JungMatthieu/UWOS/README.md

# UWOS
UWOS (UnderWater Optical Sensor), is an open source, low-cost, low power optical senso that can be synchronized with the Qualilife HighBlue (QHB, developed by the SMIoT laboratory at theUniversity of Toulon) passive acoustic recorder.
