JungMatthieu/UWOS/DOCS/STAGE___CNRS_DYNI___Cahier_des_Charges-2.pdf

# Cahier des Charges : Implémentation d’un capteur optique en « HighBlue »

### Stage de fin d’étude Mars 2025 à Août 2025

### Matthieu JUNG

Julie Patris, Hervé Glotin, Valentin Gies, Iván Hinojosa, Franck Malige,

### Lyudmyla Yushchenko

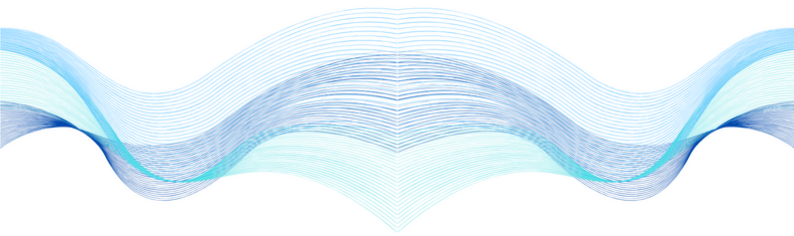
[picture p100: figure]

### Table des matières

Historique des Versions | 2
1 Object | 3
2 Cahier des charges fonctionnel (CdcF) | 5
3 Analyse Fonctionnelle Technique (AFT) | 9
4 Mode de défaillance | 21
5 Planning et suivi de projet | 22
Références | 23
Table des Figures et Tableaux | 23

1

### Historique des Versions

Version | Date | Auteur(s) | Modifications
1.0 | 10.03.2025 | M. JUNG | Cahier des charges fonctionnel
2.0 | 19.03.2025 | M. JUNG | Analyse fonctionnelle Technique
3.0 | 19.03.2025 | M. JUNG | Versión en español
4.0 | 17.03.2025 | | Finale Version

2

INTRODUCTION

### 1 Object

### 1.1 Objectif du document

Ce projet vise à compléter les enregistrements hydrophones de notre outil d’enregistrement sous-marin "Qualilife HighBlue" ancré et utilisé pour effectuer des relevés bioacoustique. Due a une convergence évolutive, certaines espèces, comme des dauphins et des marsouins émettent des clicks NBHF dans le même spectre de fréquence, il est difficile de les distinguer uniquement par l’audio comme évoquer dans (Patris 2023, [1] et Reyes Reyes 2018, [2]). L’écosystème marin du Chili est considéré comme l’un des plus riche, dans le cadre de l’étude des espèces endémique s’y trouvant, l’ajout d’un capteur optique sous-marin permettra d’améliorer l’identification des espèces grâce à une analyse visuelle, soit manuellement, soit via IA, et donc par conséquent de relier l’audio a des individus et des comportements.

### 1.2 Conventions et définitions

Ce document suit les conventions suivantes :
— Les termes techniques et acronymes spécifiques au projet sont définis dans le glossaire cidessous.
— Les références aux sources bibliographiques sont indiquées sous la forme (Auteur, année) et détaillées dans la section des références.

Définitions
— NBHF (Narrow-Band High-Frequency clicks) : Clicks de haute fréquence émis par certains cétacés comme les marsouins et certains dauphins.
— Qualilife HighBlue (QHB) : Carte électronique d’enregistrement audio
— Caméra 360° sous-marine : Système optique capable de capturer des images et vidéos panoramiques sous l’eau à différentes profondeurs.
— DC : Courant continu
— AC : Courant alternatif
— Lowpower : Conçu pour avoir une faible consommation énergétique — UWOS : UnderWater optic sensor

### 1.3 Analyse de l’existant

Aujourd’hui sur la bouée d’enregistrement, aucun capteur optique n’est présent. On note cependant la présence de deux hydrophones.

### 1.4 Public cible et lecture recommandée

Ce document est destiné à plusieurs catégories de lecteurs :
— Équipe d’ingénierie : Concepteurs, développeurs et intégrateurs du système caméra.
— Biologistes : Utilisateurs finaux exploitant les données pour l’analyse bioacoustique et comportementale.
— Spécialistes en intelligence artificielle : Développeurs d’algorithmes de reconnaissance d’espèces via l’analyse d’images et d’audio.
— Partenaires techniques et industriels : Fabricants et fournisseurs impliqués dans le développement matériel et logiciel du système.
SeaTech - SYSMER 3A | 3 | CNRS - LIS DYNI

INTRODUCTION

### 1.5 Portée du projet

Ce projet vise à concevoir et développer un système de module de capture optique adaptatif, modulable sous-marin lowpower, capable de fonctionner en milieu subaquatique pendant de longues périodes en autonomie et donc aussi dans différentes configurations.
Principaux objectifs :

— Acquisition optique complémentaire aux enregistrements acoustiques.
— Conception robuste et étanche : Résistance aux conditions extrêmes (pression, salinité, température, courant).

— Optimisation énergétique : Système lowpower permettant une autonomie prolongée.
— Stockage : Enregistrement local des vidéos.
— Traitement avancé des données : Compatibilité avec un post-processing.

Exclusions du projet :
Le projet ne comprend pas la mise en place d’un réseau de transmission temps réel longue portée, Ni le développement d’un algorithme IA complet pour l’identification des espèces est hors du périmètre initial (mais le système doit être compatible avec une future intégration).
SeaTech - SYSMER 3A | 4 | CNRS - LIS DYNI

CAHIER DES CHARGES FONCTIONNEL

### 2 Cahier des charges fonctionnel (CdcF)

### 2.1 Analyse du cycle de vie

Le cycle de vie d’un module UWOS sous-marine low-power suit plusieurs étapes, depuis sa conception jusqu’à son recyclage en fin de vie.

— Phase de conception et développement
— Phase de fabrication
— Phase de transport
— Phase d’exploitation et d’utilisation
— Fin de vie et recyclage

Dans notre cas il est possible qu’au vu de la temporalité (moins de 3 mois de R&D) de ce projet les phases de conception, fabrication et d’exploitation soit un peu confondu. En effet il est probable que la solution reste à l’état de prototype durant ce projet.

### 2.2 Éléments du milieu extérieur (EME)

L’environnement sous-marin impose des contraintes physiques et chimiques qui influencent la conception. (Pression, corrosion, salinité, visibilité...)
Les éléments du milieu extérieur sont les éléments constitutif de l’environnement de notre système optique, qui sont en interaction avec celui-ci. On retiendra les EME suivantes :

— Système d’enregistrement existant
— Utilisateur
— Réglementation et norme
— Environnement sous-marin (cf ci-dessus)

Dans les diagrammes dans la partie suivante, l’EME Système existant sera divisé en plusieurs sous-partie pour une meilleure visibilité.

SeaTech - SYSMER 3A | 5 | CNRS - LIS DYNI

CAHIER DES CHARGES FONCTIONNEL

### 2.3 Situation de vie, utilisation

### 2.3.1 Diagramme APTE

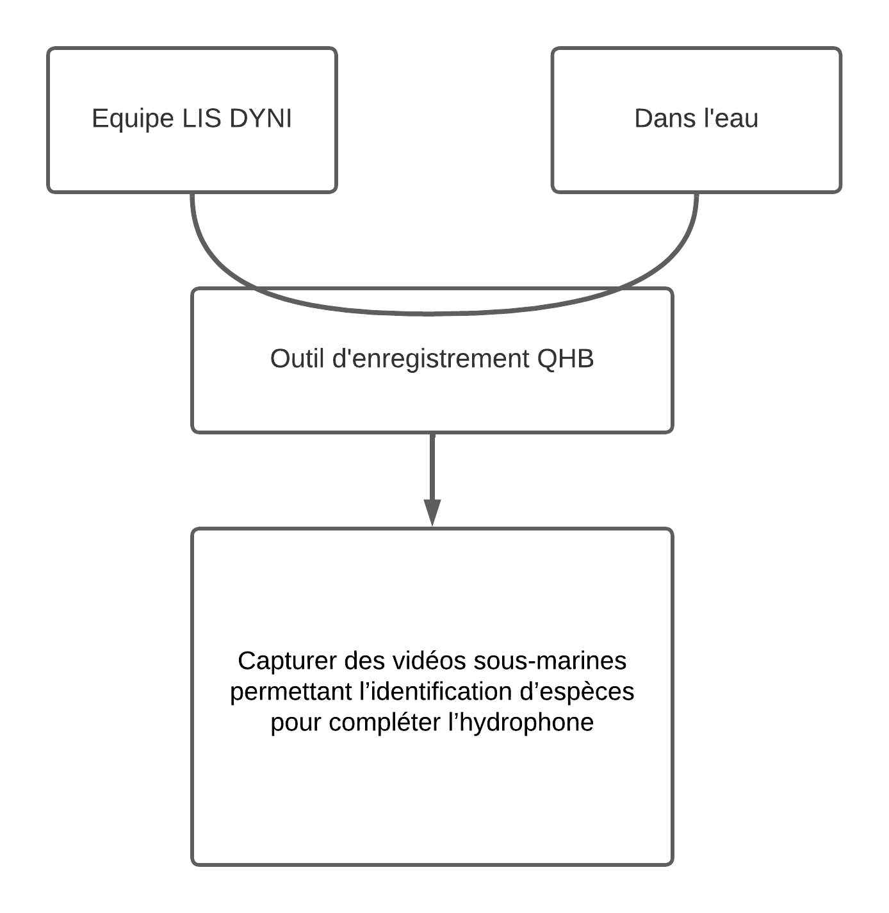
[picture p101: figure]

Figure 3 – Diagramme APTE

Le diagramme "bête à corne" permet de visualiser de manière claire et concise les différents éléments du système et leur relation les uns avec les autres. Et donc de comprendre qui utilisera notre projet, comment et pour quelles raisons. Cependant il faut lui adjoindre un autre diagramme plus complet qui lui détaillera les différentes fonctions de notre système.

### 2.3.2 Diagramme inter-acteurs

Ce deuxième diagramme permet de définir les fonctions que doit remplir notre système. Ainsi on peut déjà dégager en amont les objectifs principaux. L’objectif premier de ce projet est donc d’agrémenter l’outil d’enregistrement en lui ajoutant un capteur visuel. On peut y définir des objectifs suivants :

— Capturer des informations visuelles
— Permettre l’identification des espèces jusqu’à une certaine distance — Assurer un enregistrement autonome et synchronisé avec l’audio — Garantir une autonomie de 2 à 4 jours.
SeaTech - SYSMER 3A | 6 | CNRS - LIS DYNI

CAHIER DES CHARGES FONCTIONNEL

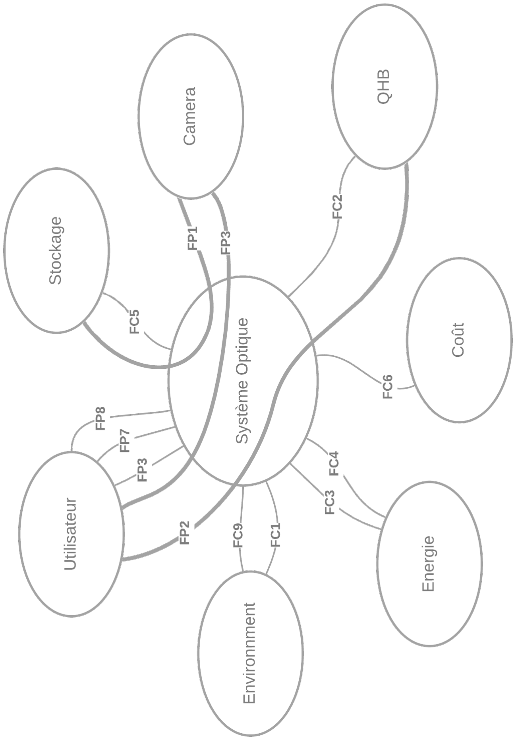
[picture p102: figure]

Figure 4 – Diagramme PIEUVRE

Voila le tableau des fonctions principales et fonctions contraintes associés au digramme pieuvre :

SeaTech - SYSMER 3A | 7 | CNRS - LIS DYNI

Fonctions Ctitères d'acceptation Niveaux d'acceptation

FLEXIBILITE

Classe Limites

Fonctions principales

FP1 Capturer des vidéos sous-marines • Résolution d'image Full HD F0 HD

- Frame Rate 24 fps F0 15 fps
- Stocker les vidéos H.264 F0 lisible en post-processing
- Filmer en grand angle objectif 180° F0 120°
- Sensibilité à la lumière 0.01 Lux F0 0.5 Lux
- Filmer en continu sur des périodes de plusieurs heures 12h F1 6h

FP2 Déclenchement des vidéos • Synchro 1ms F0 100ms

- Adapter la sensibilité capteur Avec luxmètre F0
- Gestion des modes REC / SLEEP -- F0 --

FP3 Informer l'utilisateur de l'état de l'enregistrement • Etat Rec / pas Rec F0

- Moyen d'information Visuel : LED F2 --

Fonctions secondaires

FC1 Résistance mécanique • Etanche 40m - IP68 ou plus F0 30m

- Chocs Chute 1m F0
- Température d'utilisation -10° to 40° F0 0° to 30°
- Resistance a la corrosion Accrylique ou Inox F0

FC2 S'interfacer avec l'éxistant • Masse <1kg F1 <1.5kg

- Taille depend of sensor F1
- Type et Niveau d'énergie 5V sur D alkaline F0
- Orientation module 5 choix d'orientation F1 3 choix
- connectique 1 sortie étanche min F0

FC3 Autonomie • Consommation <10W F1 ±20 %

- Gestion des mode REC et Veille F0

FC4 Batterie • Alimenter par batterie Li-Ion ou D Alkaline F1

FC5 Stockage • Tout enregistrer 512Go to 1To / V30 F1 512Go / V30

- Ne pas chauffer F2

FC6 Coût • Ne doit pas dépasser le budget 1 000€ F2 1 000€

FC7 Maintenance • Facilement ouvrable CAO F2

FC8 Exploitation • Récupération des données Donnée formaté F0

- Transportable et manipulable par des plongeurs F1
- Système fiable Eviter la corruption des données F0

FC9 Être furtif • Ne dois pas déranger l'environnement Ne pas emettre de lumière, son... F2

CAHIER DES CHARGES FONCTIONNEL

SeaTech - SYSMER 3A | 8 | CNRS - LIS DYNI

AFT

### 3 Analyse Fonctionnelle Technique (AFT)

Dans ce projet nous ne formaliserons pas le système par un SADT ou un FAST classique par manque de temps. Ainsi comme nous voulons adopter une stratégie de pensée en "Système", nous allons décrire l’architecture de chaque partie par un système de tables qui ressemble néanmoins à un SADT. Nous allons donc y décrire l’architecture de chaque partie, sous-partie et leurs interactions. Cette partie constitue le début de la phase de design de notre solution.

SeaTech - SYSMER 3A | 9 | CNRS - LIS DYNI

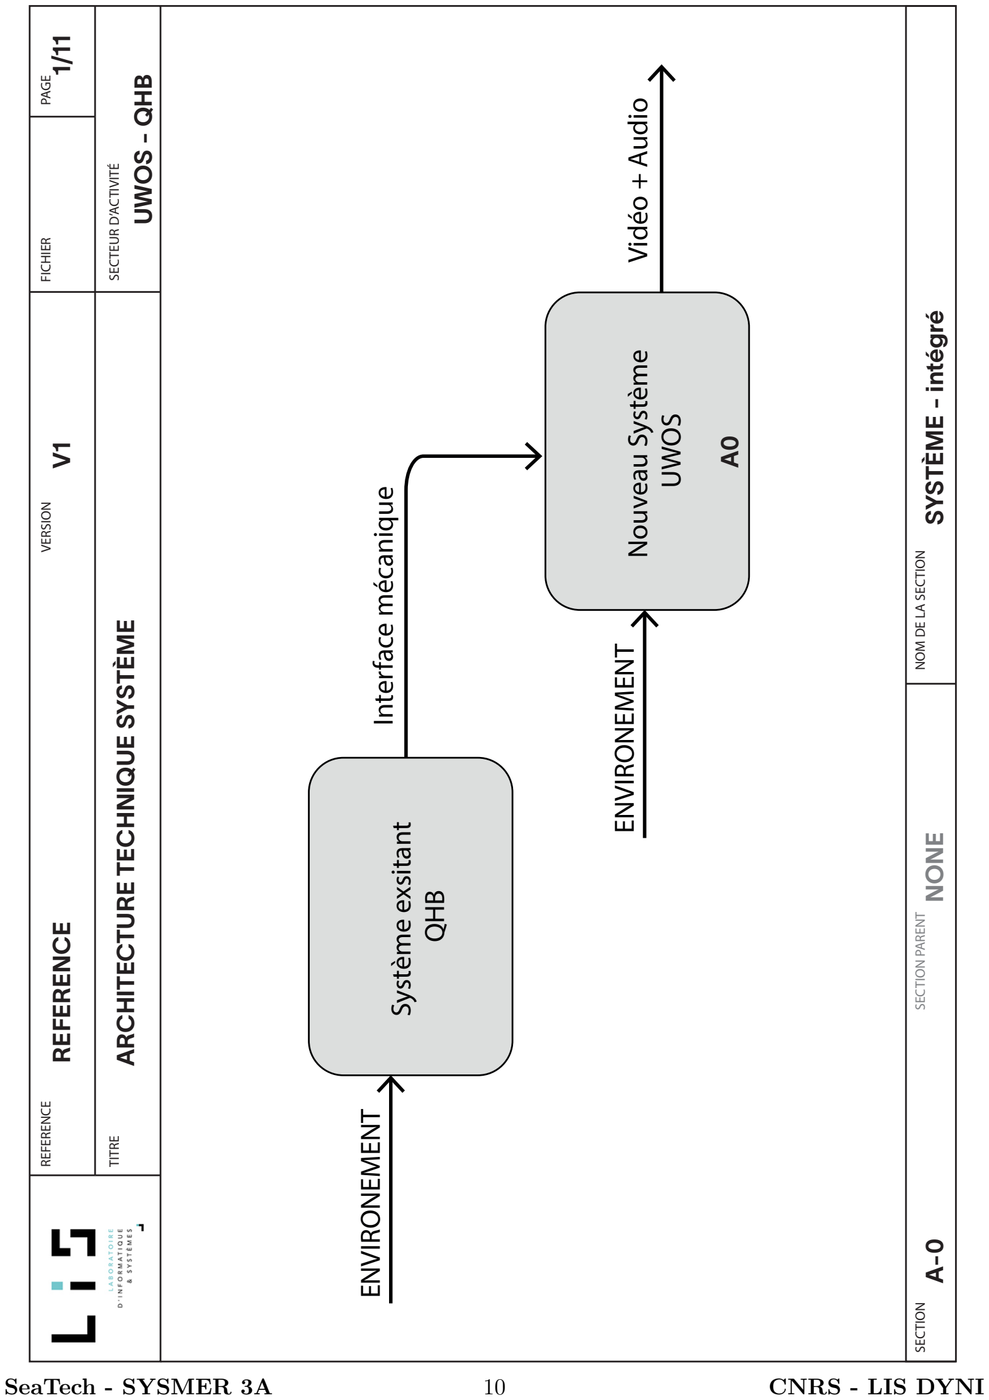
[picture p103: figure]
REFERENCE VERSION FICHIER PAGE; TITRE SECTEUR D’ACTIVITÉ; REFERENCE 1/11 V1; A-0 NONE SYSTÈME - intégré; Système exsitant; QHB; ENVIRONEMENT Interface mécanique; Nouveau Système; UWOS; ENVIRONEMENT Vidéo + Audio; SeaTech - SYSMER 3A; CNRS - LIS DYNI

NOM DE LA SECTION SECTION PARENT SECTION

# ARCHITECTURE TECHNIQUE SYSTÈME UWOS - QHB

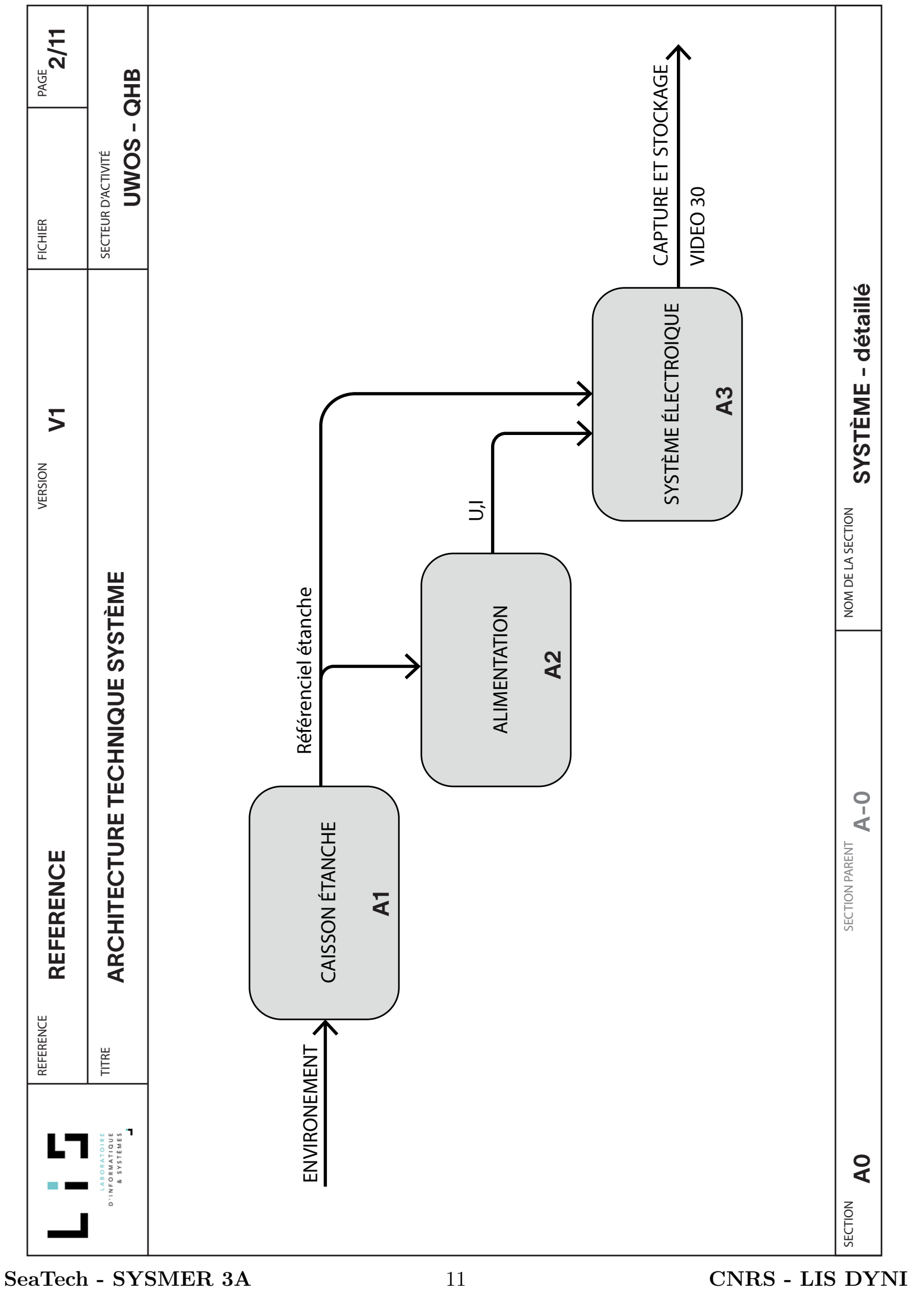
[picture p104: figure]
REFERENCE VERSION FICHIER PAGE; TITRE SECTEUR D’ACTIVITÉ; REFERENCE 2/11 V1; A0 A-0 SYSTÈME - détaillé; CAISSON ÉTANCHE; Référenciel étanche; ALIMENTATION; SYSTÈME ÉLECTROIQUE CAPTURE ET STOCKAGE; VIDEO 30; ENVIRONEMENT; SeaTech - SYSMER 3A; CNRS - LIS DYNI

NOM DE LA SECTION SECTION PARENT SECTION

# ARCHITECTURE TECHNIQUE SYSTÈME UWOS - QHB

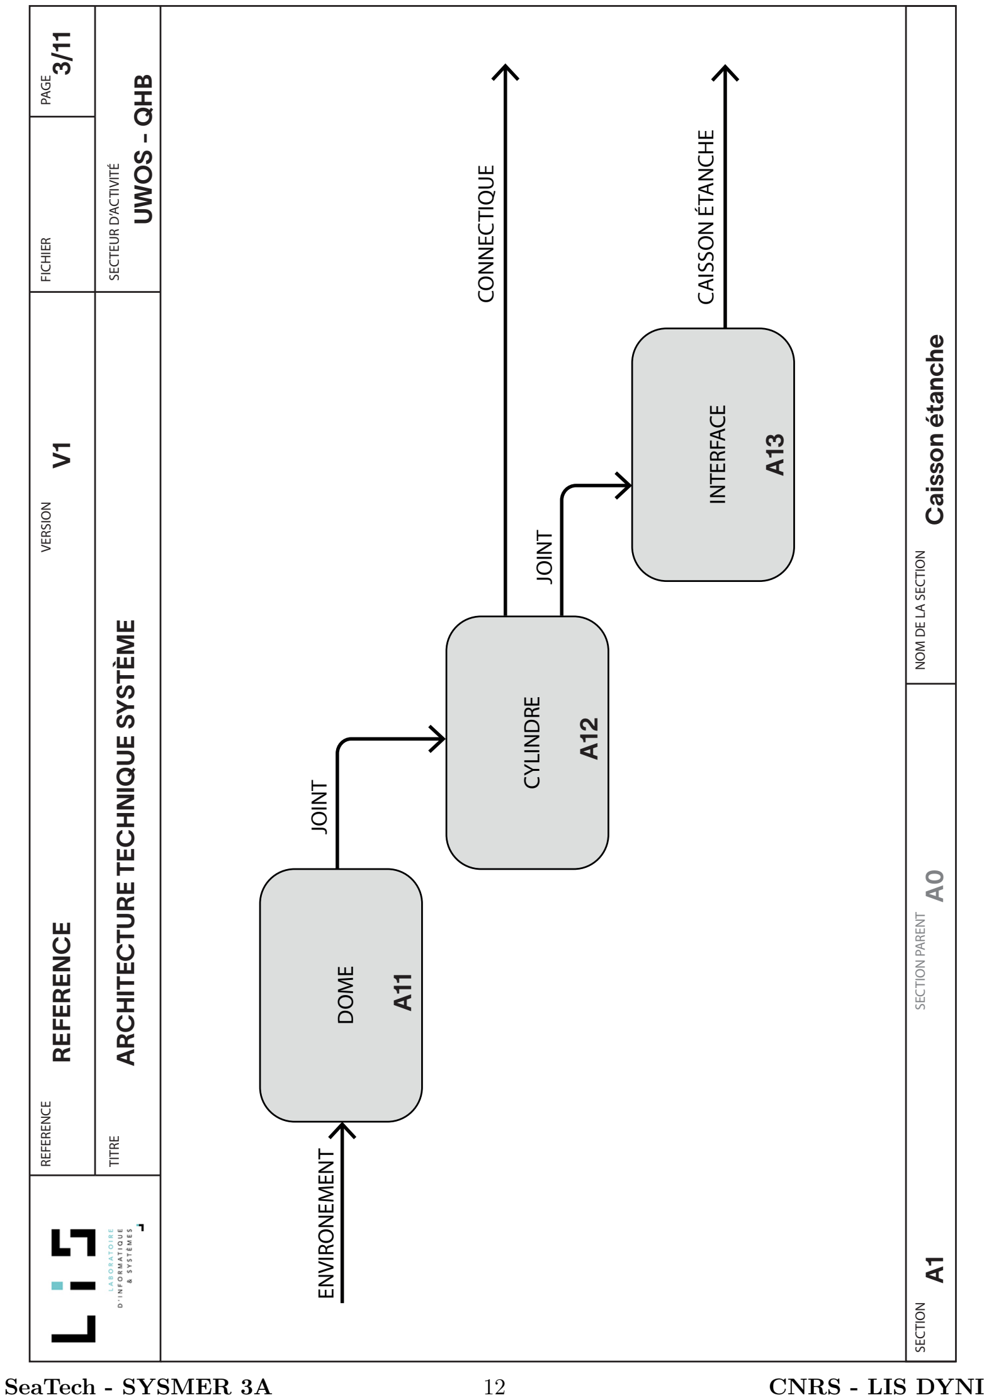
[picture p105: figure]
REFERENCE VERSION FICHIER PAGE; TITRE SECTEUR D’ACTIVITÉ; REFERENCE 3/11 V1; A1 A0 Caisson étanche; DOME; JOINT; CYLINDRE; INTERFACE CAISSON ÉTANCHE; ENVIRONEMENT; CONNECTIQUE; SeaTech - SYSMER 3A; CNRS - LIS DYNI

NOM DE LA SECTION SECTION PARENT SECTION

# ARCHITECTURE TECHNIQUE SYSTÈME UWOS - QHB

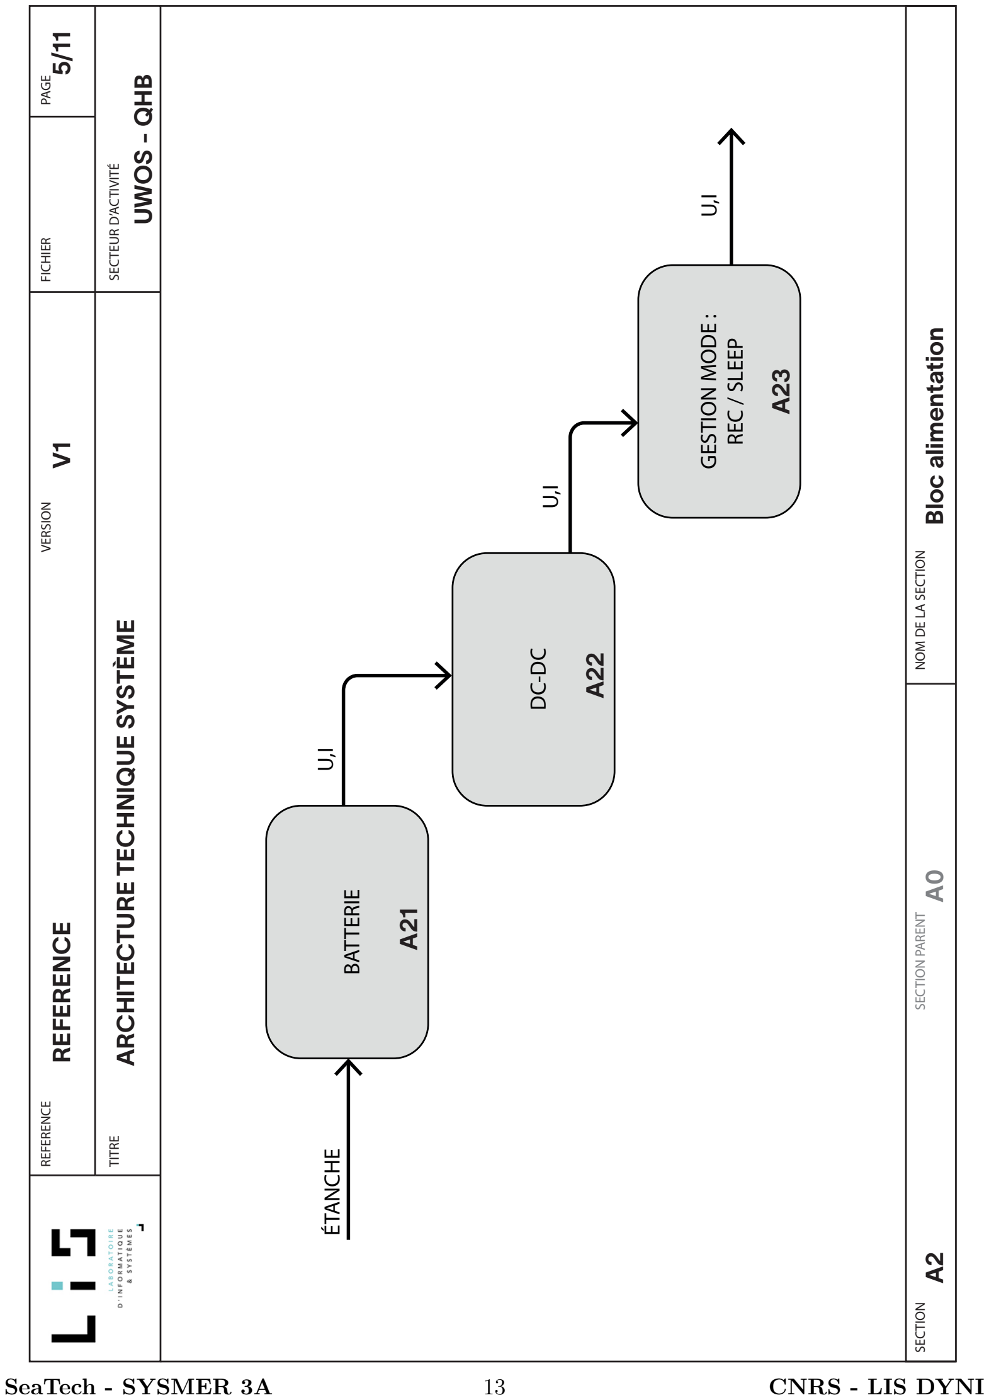
[picture p106: figure]
REFERENCE VERSION FICHIER PAGE; TITRE SECTEUR D’ACTIVITÉ; REFERENCE 5/11 V1; A2 A0 Bloc alimentation; BATTERIE; GESTION MODE : REC / SLEEP; ÉTANCHE; SeaTech - SYSMER 3A; CNRS - LIS DYNI

NOM DE LA SECTION SECTION PARENT SECTION

# ARCHITECTURE TECHNIQUE SYSTÈME UWOS - QHB

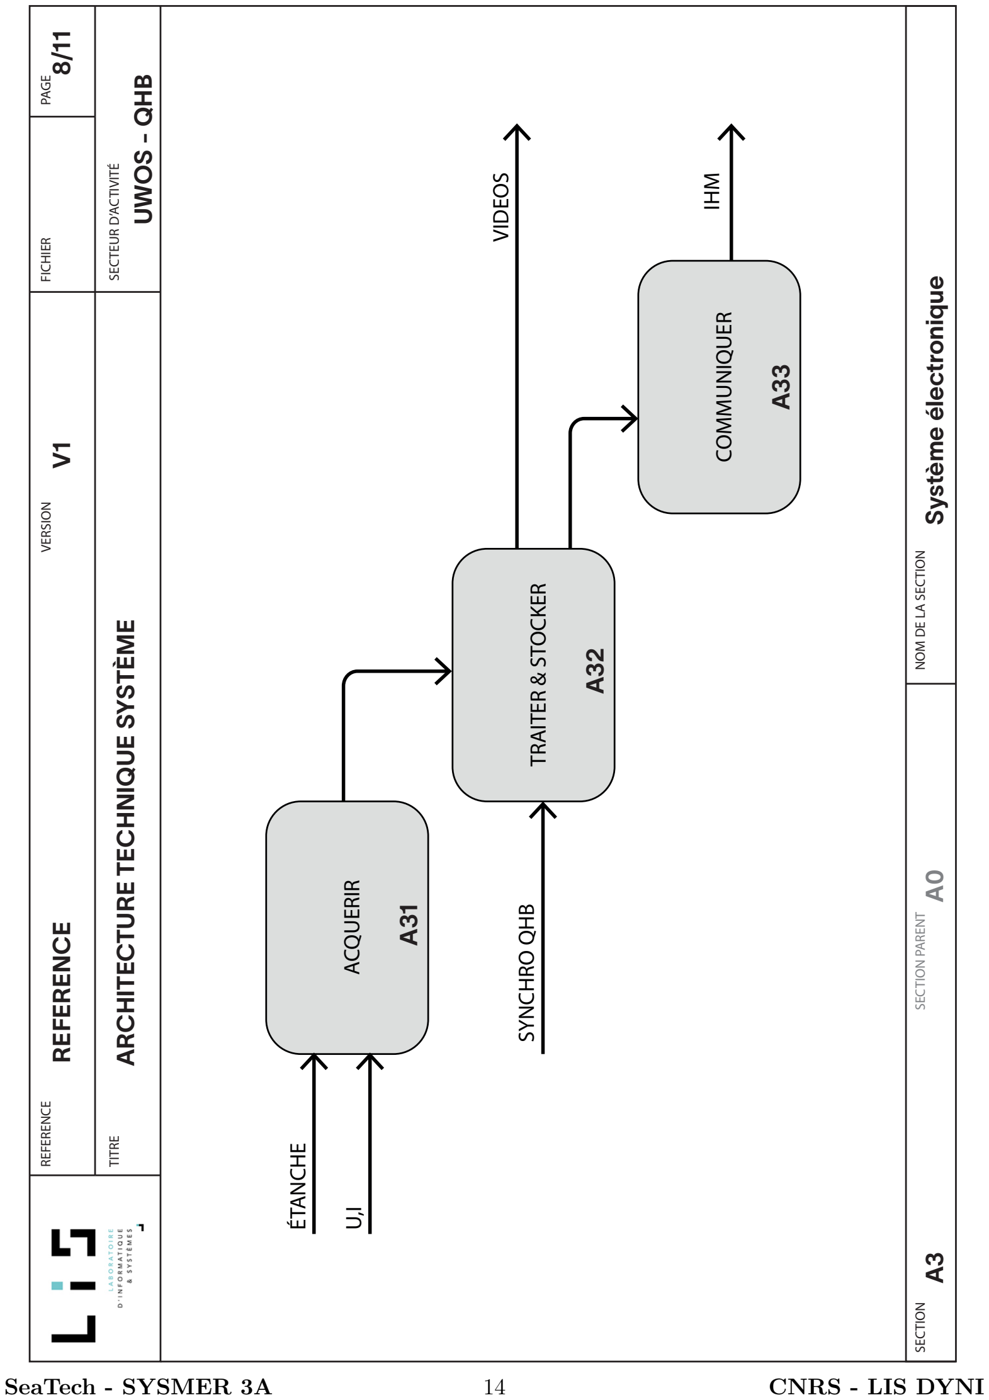
[picture p107: figure]
REFERENCE VERSION FICHIER PAGE; TITRE SECTEUR D’ACTIVITÉ; REFERENCE 8/11 V1; A3 A0 Système électronique; ACQUERIR; TRAITER & STOCKER; COMMUNIQUER; ÉTANCHE; VIDEOS; IHM; SYNCHRO QHB; SeaTech - SYSMER 3A; CNRS - LIS DYNI

NOM DE LA SECTION SECTION PARENT SECTION

# ARCHITECTURE TECHNIQUE SYSTÈME UWOS - QHB

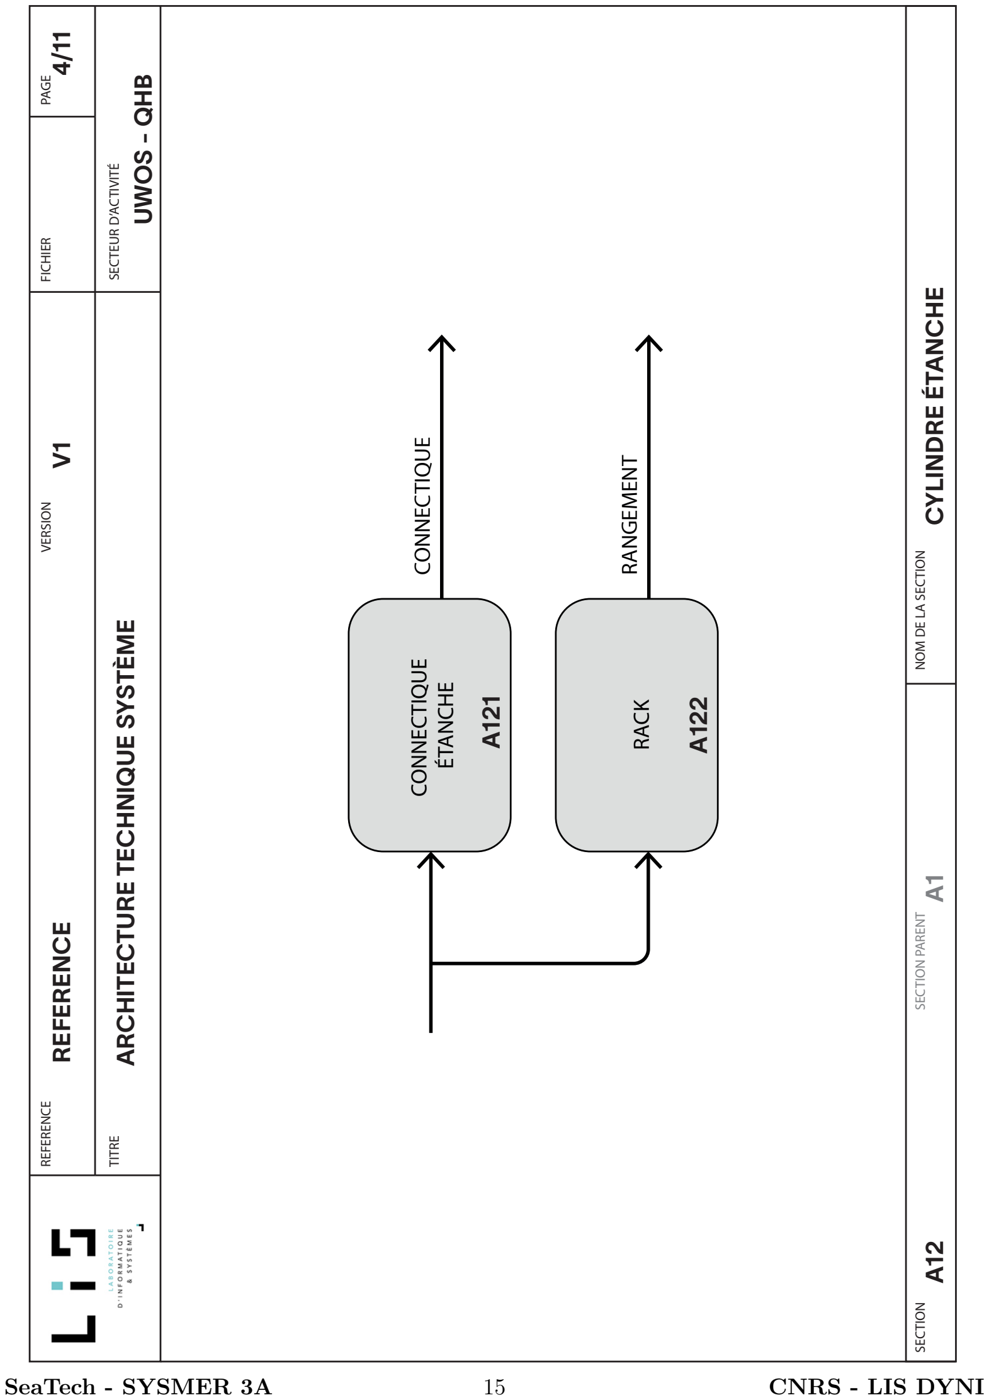
[picture p108: figure]
REFERENCE VERSION FICHIER PAGE; TITRE SECTEUR D’ACTIVITÉ; REFERENCE 4/11 V1; A12 A1 CYLINDRE ÉTANCHE; CONNECTIQUE ÉTANCHE; RACK; CONNECTIQUE; RANGEMENT; SeaTech - SYSMER 3A; CNRS - LIS DYNI

NOM DE LA SECTION SECTION PARENT SECTION

# ARCHITECTURE TECHNIQUE SYSTÈME UWOS - QHB

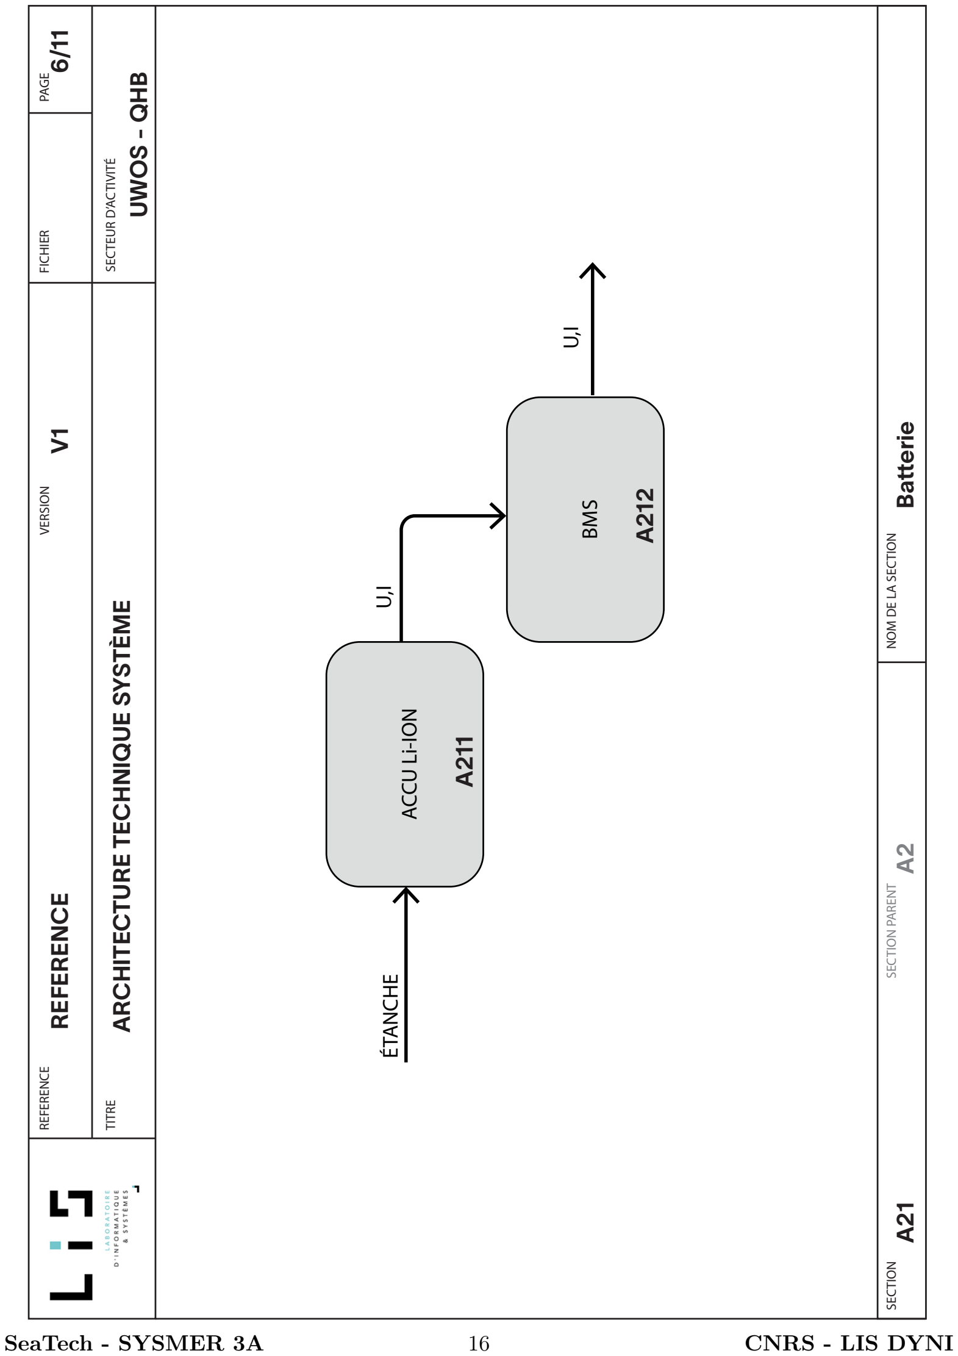
[picture p109: figure]
REFERENCE VERSION FICHIER PAGE; TITRE SECTEUR D’ACTIVITÉ; REFERENCE 6/11 V1; A21 A2 Batterie; ACCU Li-ION; BMS; ÉTANCHE; SeaTech - SYSMER 3A; CNRS - LIS DYNI

NOM DE LA SECTION SECTION PARENT SECTION

# ARCHITECTURE TECHNIQUE SYSTÈME UWOS - QHB

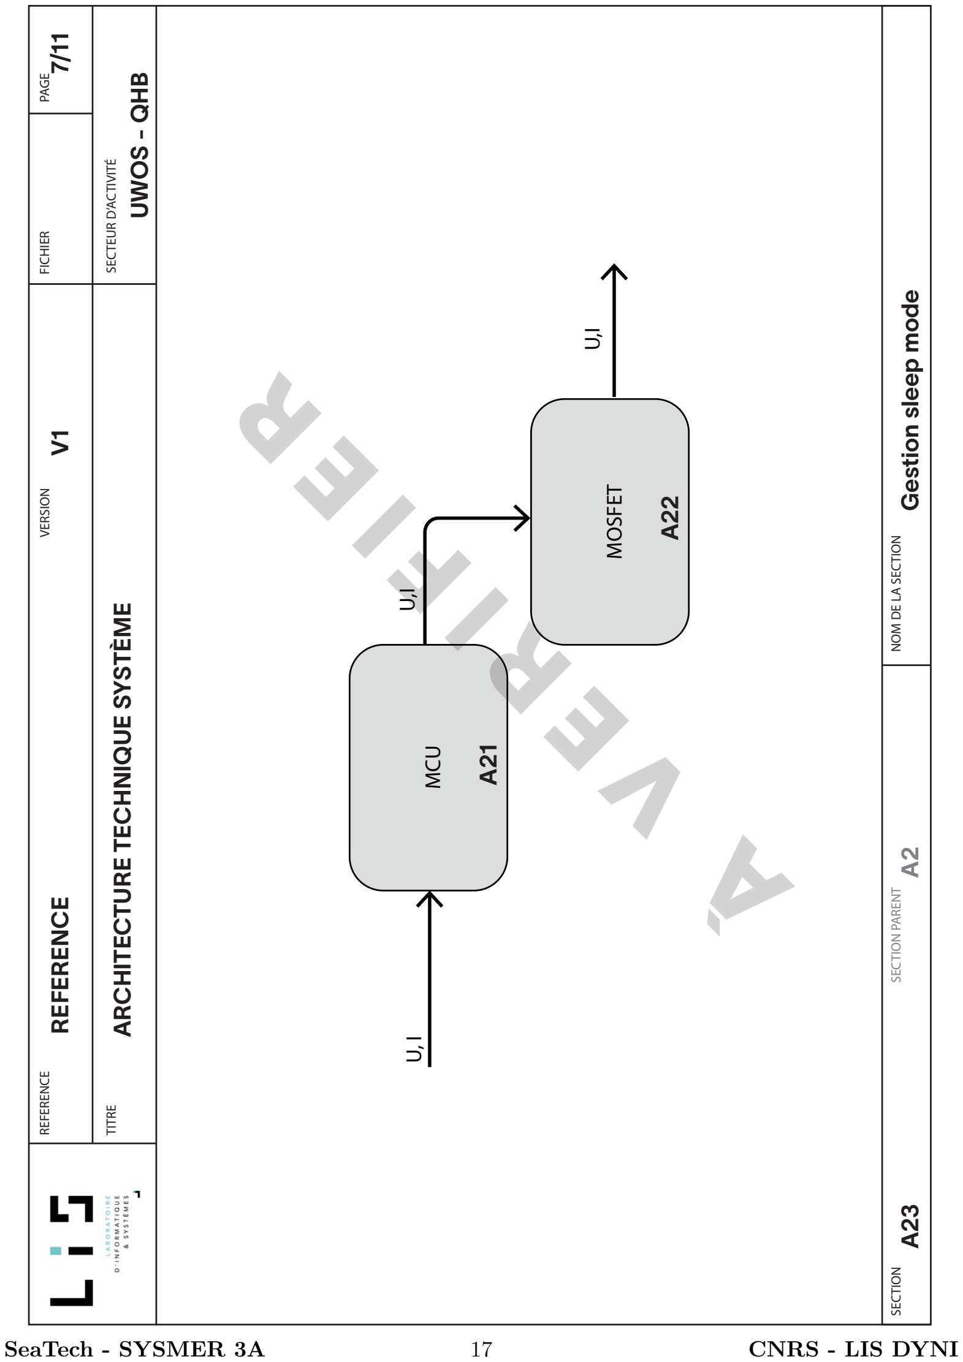
[picture p110: figure]
REFERENCE VERSION FICHIER PAGE; TITRE SECTEUR D’ACTIVITÉ; REFERENCE 7/11 V1; A23 A2 Gestion sleep mode; MCU; MOSFET; A22 À VERIFIER; SeaTech - SYSMER 3A; CNRS - LIS DYNI

NOM DE LA SECTION SECTION PARENT SECTION

# ARCHITECTURE TECHNIQUE SYSTÈME UWOS - QHB

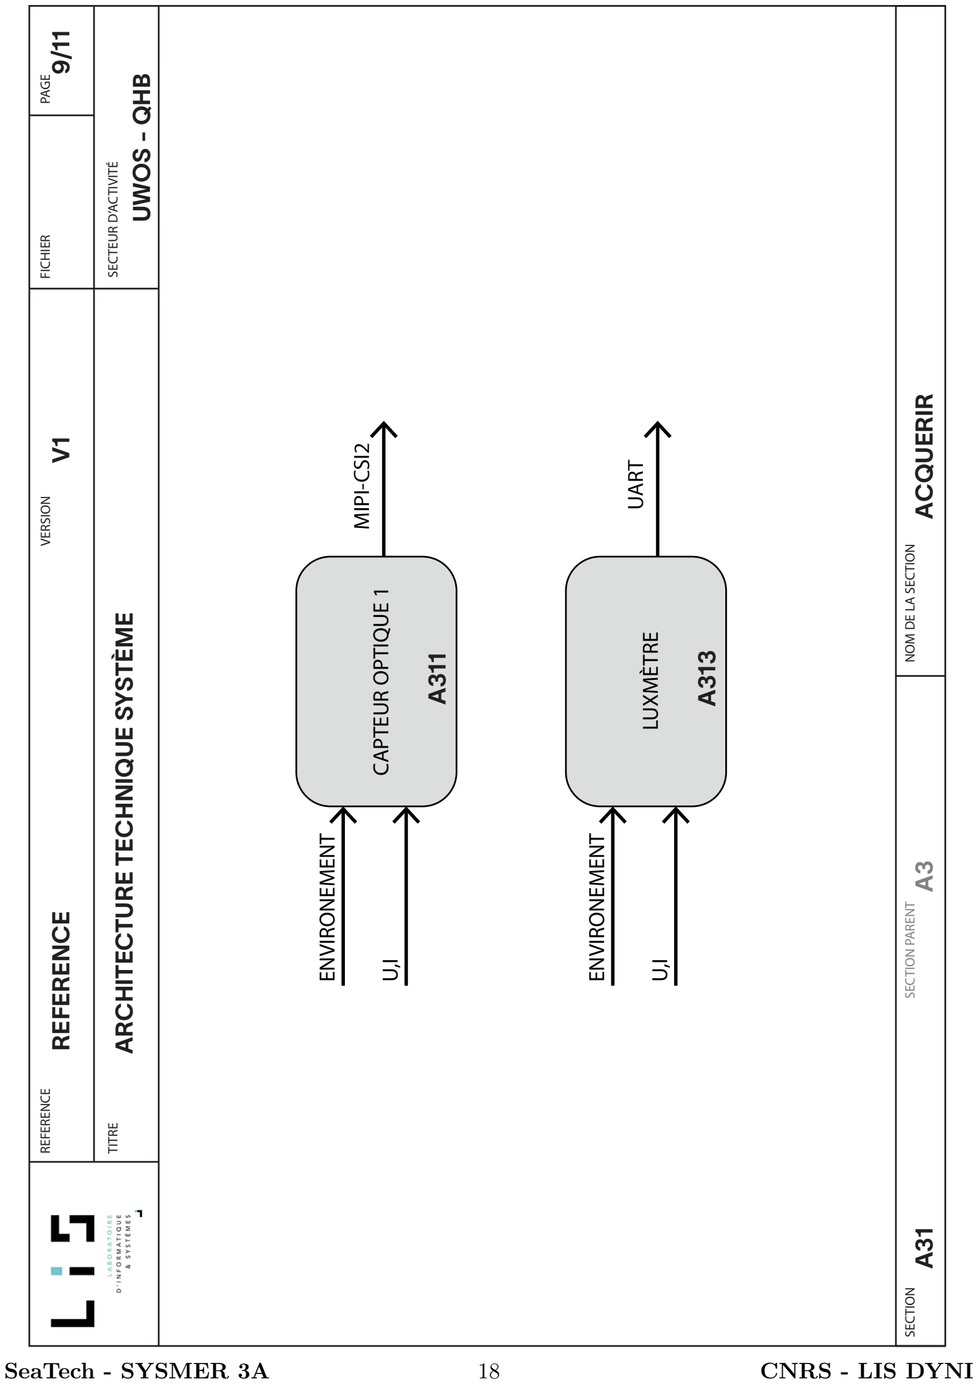
[picture p111: figure]
REFERENCE VERSION FICHIER PAGE; TITRE SECTEUR D’ACTIVITÉ; REFERENCE 9/11 V1; A31 A3 ACQUERIR; CAPTEUR OPTIQUE 1; MIPI-CSI2; ENVIRONEMENT; UART; LUXMÈTRE; SeaTech - SYSMER 3A; CNRS - LIS DYNI

NOM DE LA SECTION SECTION PARENT SECTION

# ARCHITECTURE TECHNIQUE SYSTÈME UWOS - QHB

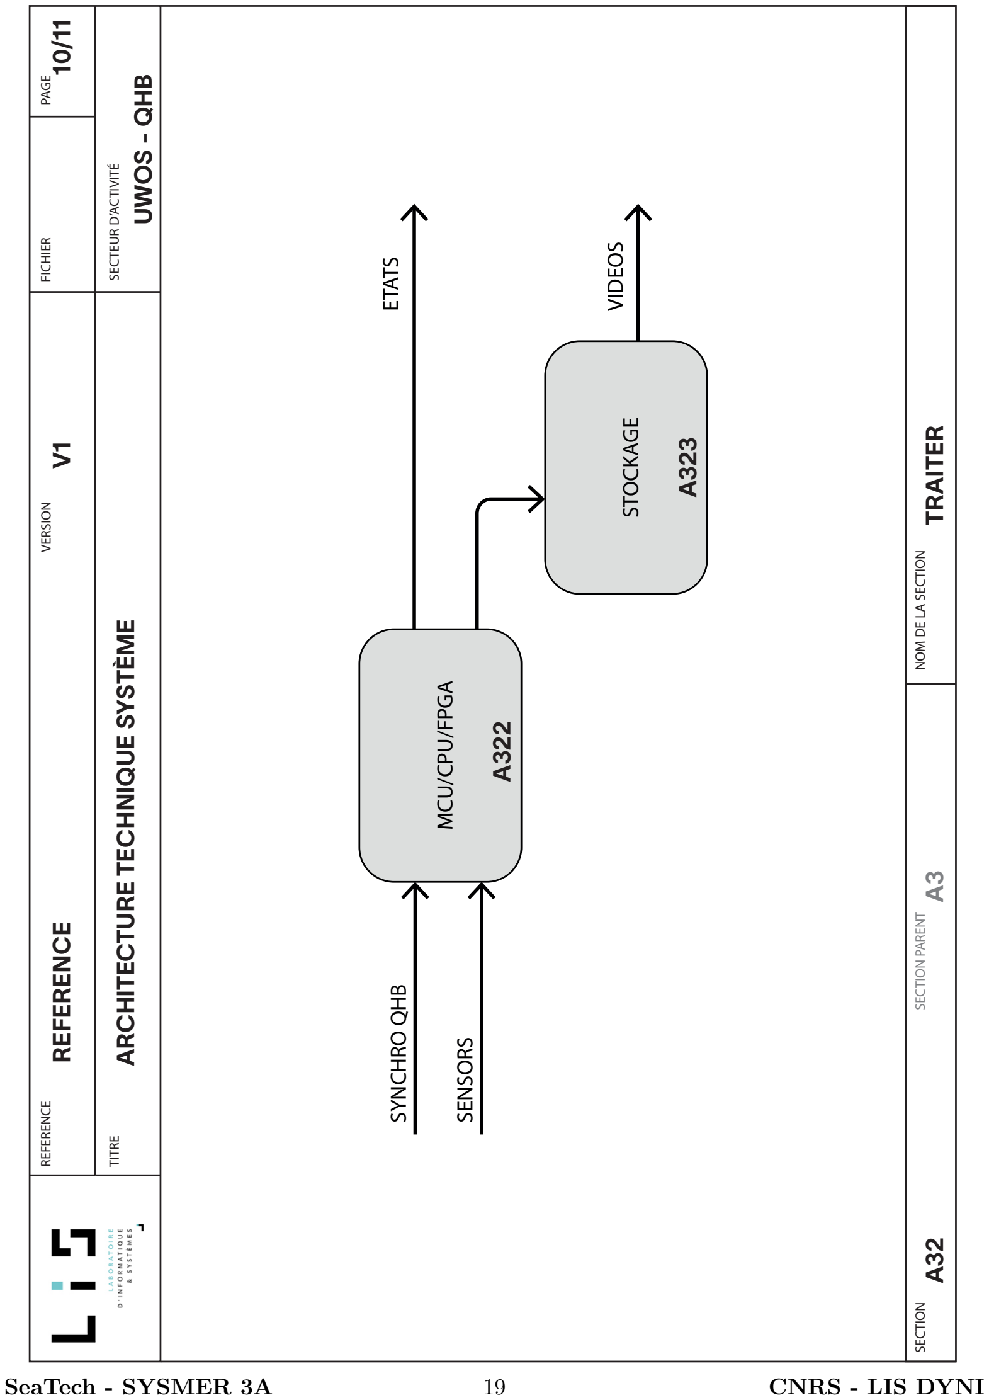
[picture p112: figure]
REFERENCE VERSION FICHIER PAGE; TITRE SECTEUR D’ACTIVITÉ; REFERENCE 10/11 V1; A32 A3 TRAITER; MCU/CPU/FPGA; STOCKAGE; ETATS; VIDEOS; SYNCHRO QHB; SENSORS; SeaTech - SYSMER 3A; CNRS - LIS DYNI

NOM DE LA SECTION SECTION PARENT SECTION

# ARCHITECTURE TECHNIQUE SYSTÈME UWOS - QHB

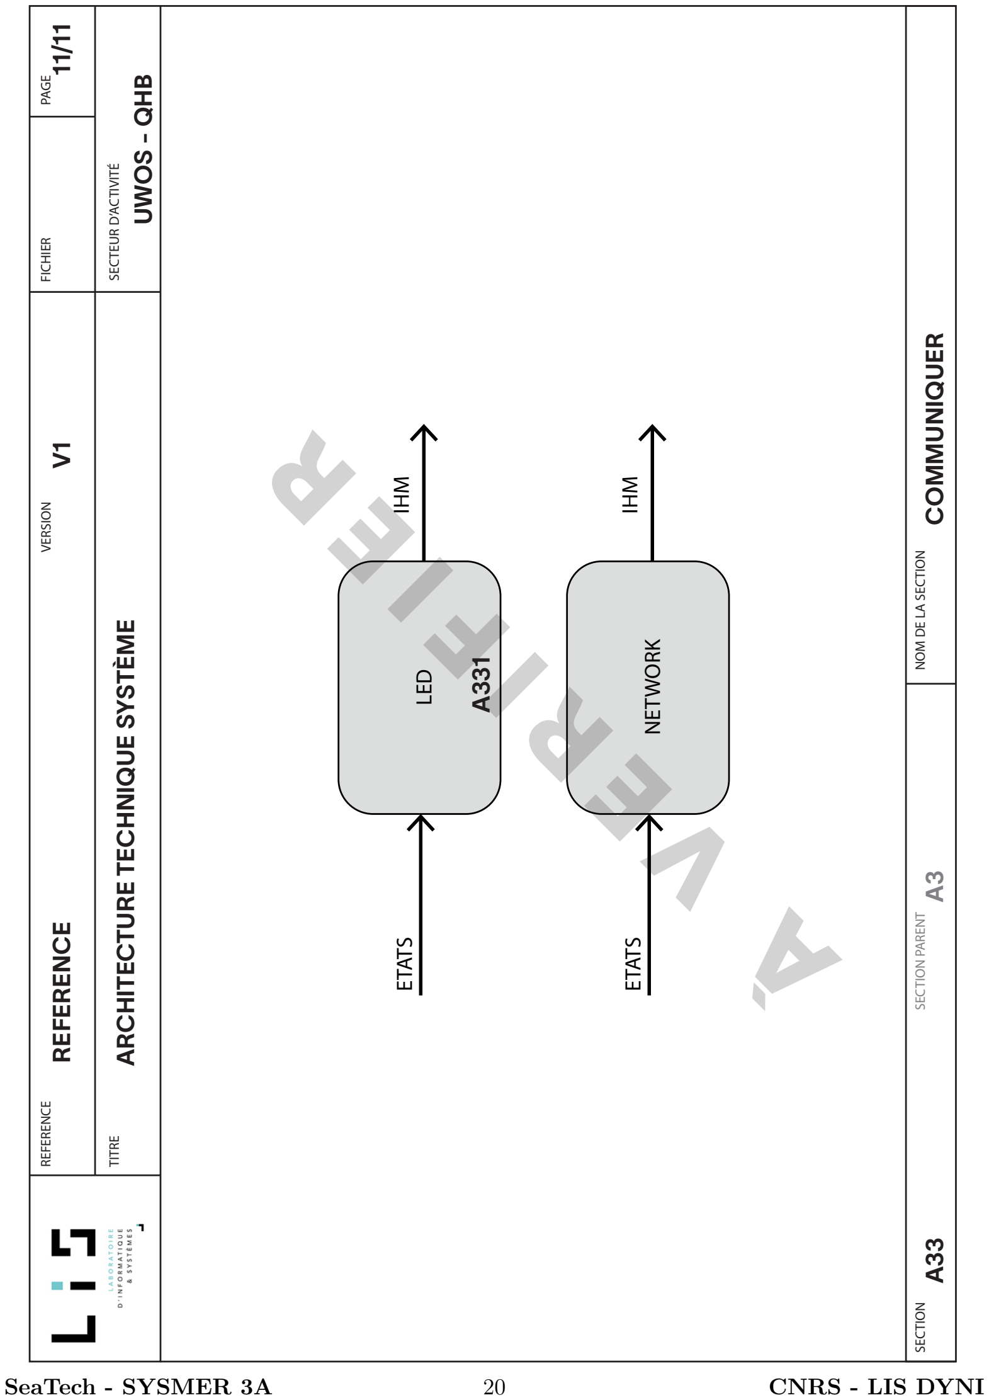
[picture p113: figure]
REFERENCE VERSION FICHIER PAGE; TITRE SECTEUR D’ACTIVITÉ; REFERENCE 11/11 V1; A33 A3 COMMUNIQUER; LED; IHM ETATS; NETWORK; A331 À VERIFIER; SeaTech - SYSMER 3A; CNRS - LIS DYNI

NOM DE LA SECTION SECTION PARENT SECTION

# ARCHITECTURE TECHNIQUE SYSTÈME UWOS - QHB

Focntion Mode de défaillance Phase de vie Événement redouté (fonction) Événement redouté

(utilisateur) Gravité Mesure à prévoir

Acquisition optique Absence de fonction Exploitation Aucune image capturée Pas d’identification des

espèces 1,00 Vérification des connexions,
redémarrage automatique

Fonction dégradée Exploitation Images floues ou bruitées Mauvaise interprétation des données 0,60 Calibration automatique,

algorithme de correction

Synchronisation

## Audio/Vidéo Perte de fonction Exploitation Décalage temporel entre son et

image Analyse incohérente 0,80

Algorithme de

synchronisation et buffer de

correction

Stockage des données Fonction intempestive Exploitation Écriture en boucle, perte de

## données Données perdues 1,00 Vérification mémoire, mise en

tampon redondante

Perte de fonction Exploitation Aucun enregistrement sauvegardé Analyse impossible 1,00 Redondance du stockage,

tests périodiques
Alimentation électrique Perte de fonction Exploitation Arrêt du capteur Capteur inutilisable 0,60 MAJ du système

Fonction dégradée Exploitation Faible autonomie Temps de capture réduit 0,60 Optimisation de la gestion

énergétique

Étanchéité Fonction dégradée Exploitation Infiltration d’eau, court-circuit Panne définitive 1 Test de pression, joints

renforcés

Interface utilisateur Absence de fonction Exploitation Aucune indication d’état Mauvaise compréhension

du statut 0,1 none

Système de fixation Fonction intempestive

(vibrations)

Transport/Installa

tion

Mauvaise stabilité, angles

incorrects

Mauvaise captation des

images 0,33 Redondance fixation

Perte de fonction Exploitation Mauvaise stabilité, angles incorrects Analyse difficile 0,5 Redondance fixation

Résistance mécanique Fonction dégradée Exploitation Déformation de la structure Détérioration prématurée 0,33 Utilisation de matériaux

renforcés

Résistance aux chocs Fonction intempestive Exploitation Chute entraînant des dégâts

internes

Dysfonctionnement

## prématuré 0,5 Tests de choc, mousse de

protection

Gestion thermique Fonction dégradée Exploitation Surchauffe Risque de panne et de condensation 0,66 Dissipation thermique,

optimisation énergétique

Gestion des modes REC /

SLEEP Fonction intempestive Exploitation Passage en mode veille inopiné Perte d’enregistrement 0,66 Algorithme de gestion

optimisé

### 4 Mode de défaillance

Il est important des le début du projet de prévoir ses mode de défaillance pour savoir comment on veut que le système réponde en cas de problème mécanique ou électronique. Voici donc un tableau des modes de défaillance de chaque fonction :

SeaTech - SYSMER 3A | 21 | CNRS - LIS DYNI

### 5 Planning et suivi de projet

Afin d’estimer la durée accordé à chaque tâche on a réalisé un diagramme de GANTT en étant le plus exhaustif possible. On a donc bien un début de projet le 03/05/2025, une semaine d’interruption du 16/05 au 22/05. Semaine avant laquelle le prototype doit être validé.

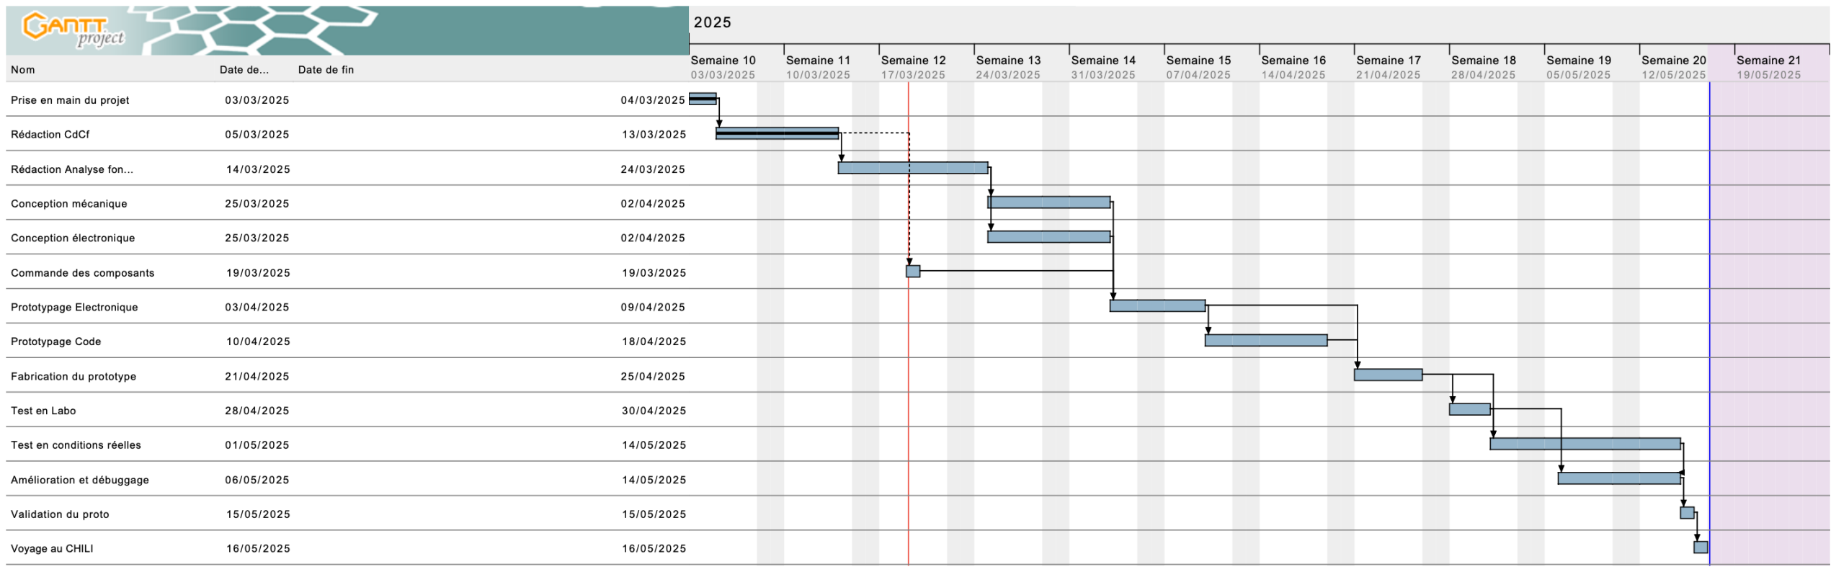
[picture p114: figure]

Figure 5 – Diagramme de Gantt

Nom | date de début | Date de fin
Prise en main du projet | 04/03/2025 | 04/03/2025
Rédaction du CdC fonctionnel | 05/03/2025 | 13/03/2025
Rédaction Analyse fonctionnelle Technique | 14/03/2025 | 24/03/2025
Commande des composants | 19/03/2025 | 19/03/2025
Conception Mécanique | 25/03/2025 | 02/04/2025
Conception Électronique | 25/03/2025 | 02/04/2025
Prototypage Électronique | 04/04/2025 | 10/04/2025
Prototypage Code | 11/04/2025 | 21/04/2025
Fabrication du Prototype | 22/04/2025 | 28/04/2025
Test en Labo | 29/04/2025 | 01/05/2025
Test en condition Réelle | 02/05/2025 | 15/05/2025
Amélioration et débuggage | 07/05/2025 | 15/05/2025
Validation du proto | 16/05/2025 | 16/05/2025

Table 2 – Tâches à réaliser durant les 3 premiers mois

SeaTech - SYSMER 3A | 22 | CNRS - LIS DYNI

### Références

[1] Julie Patris et al. « Medium-term acoustic monitoring of small cetaceans in Patagonia, Chile ». In : PeerJ 133.2 (2023), p. 731. issn : 00014966. doi : 10.7717/peerj.15292. (https://doi.org/10.7717/peerj.15292)
[2] M. Vanesa Reyes Reyes et al. « Clicks of wild Burmeister’s porpoises (Phocoena spinipinnis) in Tierra del Fuego, Argentina ». In : Marine Mammal Science XXX.XX (2018), p. 1070-1081. issn : XXX. doi : 10.1111/mms.12489. (https://doi.org/10.1111/mms.12489)

### Table des figures

3 | Diagramme APTE | | 6
4 | Diagramme PIEUVRE | | 7
5 | Diagramme de Gantt | | 22

### Liste des tableaux

2 | Tâches à réaliser durant les 3 premiers mois | | 22
SeaTech - SYSMER 3A | 23 | CNRS - LIS DYNI
