JungMatthieu/UWOS/CAD/support_int_rpi.STL

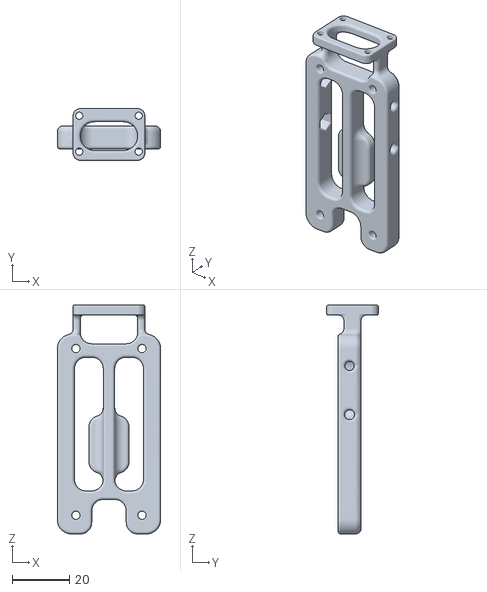
[picture p115: CAD file, 2025-08-22]
CAD/support_int_rpi.STL
36.0 x 18.0 x 79.7
