JungMatthieu/UWOS/CAD/8x_entretoise_lisse_M2-5x2.STL

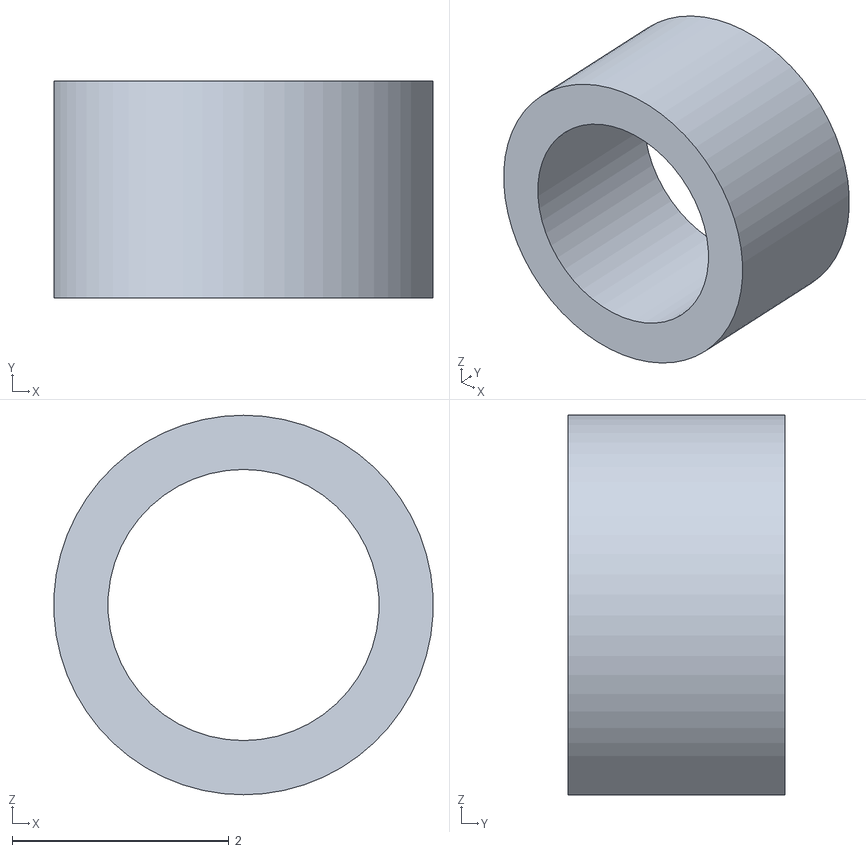
[picture p116: CAD file, 2025-08-22]
CAD/8x_entretoise_lisse_M2-5x2.STL
3.49 x 2.00 x 3.50
