JungMatthieu/UWOS/CAD/support_double_UWOS.STL

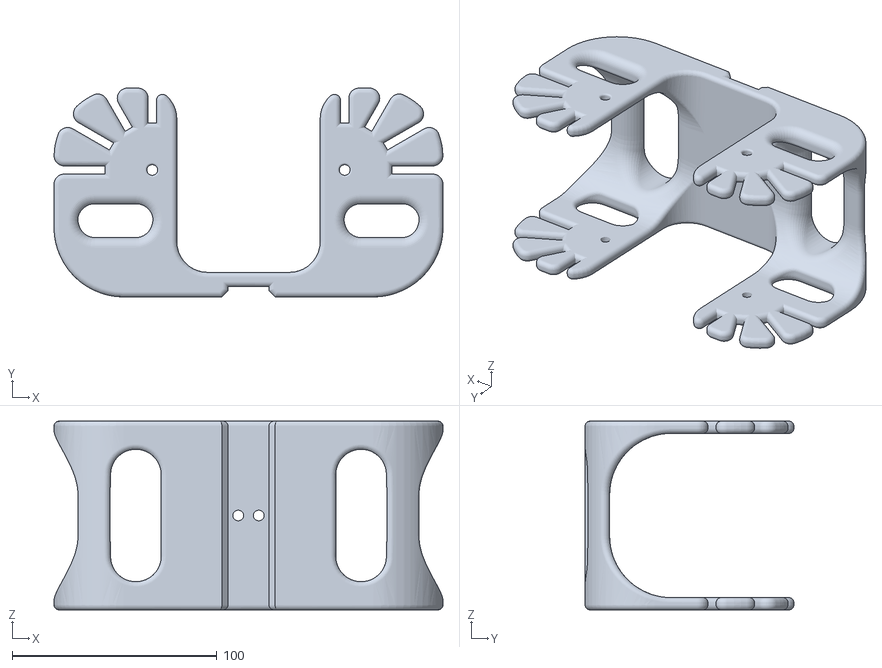
[picture p117: CAD file, 2025-08-22]
CAD/support_double_UWOS.STL
190.0 x 102.0 x 92.2
