JungMatthieu/UWOS/CAD/rail_50mm_69mm_cam.STL

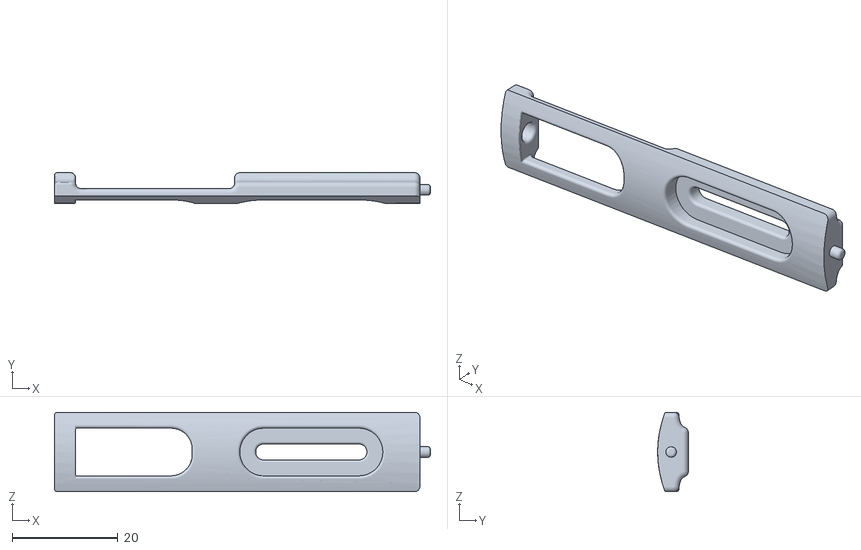
[picture p118: CAD file, 2025-08-22]
CAD/rail_50mm_69mm_cam.STL
71.0 x 5.80 x 15.0
